adityuhkapoor/fpga-pi-parallel-nids/TELEMETRY_VECTORS.md

# Telemetry response vectors — encoder/decoder cross-check (Tier 1)

Format-only vectors for the 32-byte v2 telemetry response frames (`PROTOCOL.md` § Telemetry
responses). Each row is the parsed fields ⇄ the exact bytes on MISO. Pins the byte layout
decoupled from any classifier or window-counter behavior, so both sides verify independently:

- **FPGA side:** `nids_top.v`'s response mux drives these field values and must emit the listed
  hex. (Pin via a Verilog vector tb if drift becomes a concern — currently the round-trip in
  `tb_nids_top` checks the magic; full opcode response correctness lives in the silicon test.)
- **Pi side:** `decode_query()` / `decode_snapshot()` / `decode_hll()` in `telemetry.py` parse
  each hex back to the listed fields (`test_telemetry.py`). The hex below was generated by the
  Pi-side `encode_*` helpers (the verified inverse of the decoders).

These are **not** classifier-derived; a header does not map to a response here. Window-state
correctness is the silicon test's job.

## Vectors

| Opcode | Fields | 32-byte frame (hex) |
|---|---|---|
| `0x01` | `key=CB007105, count=9` | `5acb007105000900000000000000000000000000000000000000000000000000` |
| `0x02` | `window=0, total=20, harmonic_sum=0x07FB92000000, zeros=2042, top1_count=9, top1_key=CB007105` | `5a00000000001407fb9200000007fa0009cb0071050000000000000000000000` |
| `0x03` | `harmonic_sum=0x07FB92000000, zeros=2042, m=2048` | `5a07fb9200000007fa0800000000000000000000000000000000000000000000` |
| (no-response) | all-zero (magic `≠ 0x5A`) | `0000000000000000000000000000000000000000000000000000000000000000` |

Bytes 0 is `0x5A` (alternating-bit sync pattern, distinct from the verdict's `0xA5`) for any
valid telemetry response; receivers must reject a frame whose byte 0 is anything else.
