adityuhkapoor/fpga-pi-parallel-nids/fpga/sim/tb_rule_lookup.v

`timescale 1ns/1ps
// rule_lookup + rule_store wired together: preload rules via rule_store.w_*, query via
// rule_lookup.in_valid + src_ip. Cover: match (src+epoch), no-match (epoch differs),
// no-match (different src at same hash idx), unwritten bucket.
module tb_rule_lookup;
    reg         clk = 1'b0, rst = 1'b1;
    reg [31:0]  src_ip = 32'd0;
    reg         in_valid = 1'b0;
    reg [7:0]   current_rule_epoch = 8'd0;
    wire [8:0]  rs_r_idx;
    wire [71:0] rs_r_rule;
    wire        match, out_valid;
    wire [7:0]  action;
    wire [3:0]  severity;

    // Pi-side writes into rule_store (driven by the tb)
    reg [8:0]   w_idx = 9'd0;
    reg [71:0]  w_rule = 72'd0;
    reg         w_en   = 1'b0;

    rule_store u_rs (.clk(clk),
                     .w_idx(w_idx), .w_rule(w_rule), .w_en(w_en),
                     .r_idx(rs_r_idx), .r_rule(rs_r_rule));

    rule_lookup dut (.clk(clk), .rst(rst), .src_ip(src_ip), .in_valid(in_valid),
                     .current_rule_epoch(current_rule_epoch),
                     .rs_r_idx(rs_r_idx), .rs_r_rule(rs_r_rule),
                     .match(match), .out_valid(out_valid),
                     .action(action), .severity(severity));

    always #5 clk = ~clk;
    integer errors = 0;

    // Combinational lookup_idx (same hash as rule_lookup) -- helps the tb compute where to write.
    function [8:0] hash_idx(input [31:0] ip);
        reg [63:0] p; begin p = {32'd0, ip} * 32'h9E3779B1; hash_idx = p[31:23]; end
    endfunction

    // 72-bit packed rule: src(32) | action(8) | sev(8 low4) | epoch(8) | rsv(16)
    function [71:0] mk_rule(input [31:0] s, input [7:0] a, input [3:0] sv, input [7:0] e);
        mk_rule = {s, a, 4'd0, sv, e, 16'd0};
    endfunction

    task write_rule_at(input [31:0] s, input [7:0] a, input [3:0] sv, input [7:0] e);
        begin w_idx = hash_idx(s); w_rule = mk_rule(s, a, sv, e); w_en = 1'b1;
              @(posedge clk); #1; w_en = 1'b0; end
    endtask

    task query(input [31:0] s, input [7:0] e);
        begin
            @(posedge clk); #1;
            src_ip = s; current_rule_epoch = e; in_valid = 1'b1;
            @(posedge clk); #1; in_valid = 1'b0;
            @(posedge out_valid); #1;
        end
    endtask

    task expect_match(input exp_m, input [7:0] exp_a, input [3:0] exp_s, input [127:0] tag);
        begin
            if (match !== exp_m || (exp_m && (action !== exp_a || severity !== exp_s))) begin
                $display("FAIL [%0s]: match=%b act=%02h sev=%0d, want match=%b act=%02h sev=%0d",
                         tag, match, action, severity, exp_m, exp_a, exp_s);
                errors = errors + 1;
            end
        end
    endtask

    initial begin
        #20 rst = 1'b0; @(posedge clk); #1;

        // preload three rules
        write_rule_at(32'hCB007105, 8'b101, 4'd3, 8'd7);
        write_rule_at(32'hC0000201, 8'b010, 4'd2, 8'd0);
        // a colliding src for CB007105 (hash collision in lookup_idx) -- will NOT match
        // because we don't write src=that_ip's rule. We just rely on the lookup_idx for the
        // colliding cand we computed offline. Use the same src_b from tb_flow_table: 0x0A000CF5.
        // (Whether 0x0A000CF5 collides with 0xCB007105 in lookup_idx isn't guaranteed; pick a
        //  test ip whose hash != CB007105's so we get a clean "no_match" case at a different idx.)

        // query 1: same src+epoch -> MATCH with action=5, sev=3
        query(32'hCB007105, 8'd7);
        expect_match(1'b1, 8'b101, 4'd3, "match");

        // query 2: same src, WRONG epoch -> no match
        query(32'hCB007105, 8'd8);
        expect_match(1'b0, 8'd0, 4'd0, "wrong_epoch");

        // query 3: different src (different idx) -> no match (unwritten bucket reads zero)
        query(32'h0A000001, 8'd0);
        expect_match(1'b0, 8'd0, 4'd0, "unwritten_idx");

        // query 4: same src as rule 2 at its epoch -> MATCH
        query(32'hC0000201, 8'd0);
        expect_match(1'b1, 8'b010, 4'd2, "rule2");

        if (errors == 0) $display("PASS: tb_rule_lookup (match + epoch-miss + unwritten)");
        else             $display("FAIL: %0d error(s)", errors);
        $finish;
    end
endmodule
