adityuhkapoor/fpga-pi-parallel-nids/(commit log)

2026-05-16 Add SPI link and loopback self-test
2026-05-17 wire spi into capture
2026-05-18 Add FPGA toolchain smoke test (switches->LEDs)
2026-05-19 add spi slave receiver
2026-05-27 scan_rate hdl + wire-up + timing closure
2026-05-27 terminal visualizer + benchmark fix
    [benchmark.py, test_viz_core.py, viz.py, viz_core.py]
2026-05-31 flow table + closed loop
